seminolemuscle/V0.25/BOM/OpenBarbell_V0p25_BOM.xls

Bill of Materials (BOM) for OpenBarbell V0.25
Ref Des | Location | Description | Qty | Manufacturer | Mfg Part # | Type | Packaging | Datasheet | Link to Product
LED2 | Top | LED RED DIFFUSED 0805 SMD | 1 | OSRAM Opto Semiconductors Inc. (http://digikey.com/Suppliers/us/Osram.page?lang=en) | LH R974-LP-1 | SMD | 0805 (2012 Metric) | http://www.osram-os.com/Graphics/XPic8/00078869_0.pdf | http://www.digikey.com/scripts/DkSearch/dksus.dll?Detail&itemSeq=186757357&uq=635871091745723126
D1 | Top | DIODE SCHOTTKY 20V 1A SOD123 | 1 | Micro Commercial Co (http://digikey.com/Suppliers/us/Micro-Commercial-Components.page?lang=en) | MBRX120-TP | SMD | SOD-123 | http://www.mccsemi.com/up_pdf/MBRX120-MBRX160(SOD123).pdf | http://www.digikey.com/scripts/DkSearch/dksus.dll?Detail&itemSeq=186757358&uq=635871091745733126
C2 | Top | CAP TANT 10UF 6.3V 20% 0805 | 3 | AVX Corporation (http://digikey.com/Suppliers/us/AVX.page?lang=en) | F920J106MPA | SMD | 0805 (2012 Metric) | http://datasheets.avx.com/f92.pdf | http://www.digikey.com/scripts/DkSearch/dksus.dll?Detail&itemSeq=186757354&uq=635871091745733126
C7 | Top | CAP TANT 10UF 6.3V 20% 0805 | 3 | AVX Corporation (http://digikey.com/Suppliers/us/AVX.page?lang=en) | F920J106MPA | SMD | 0805 (2012 Metric) | http://datasheets.avx.com/f92.pdf | http://www.digikey.com/scripts/DkSearch/dksus.dll?Detail&itemSeq=186757354&uq=635871091745733126
C9 | Top | CAP TANT 10UF 6.3V 20% 0805 | 3 | AVX Corporation (http://digikey.com/Suppliers/us/AVX.page?lang=en) | F920J106MPA | SMD | 0805 (2012 Metric) | http://datasheets.avx.com/f92.pdf | http://www.digikey.com/scripts/DkSearch/dksus.dll?Detail&itemSeq=186757354&uq=635871091745733126
LED1 | Top | LED GREEN CLEAR 0805 SMD | 1 | Lite-On Inc. (http://digikey.com/Suppliers/us/Lite-On.page?lang=en) | LTST-C171GKT | SMD | 0805 (2012 Metric) | http://media.digikey.com/pdf/Data%20Sheets/Lite-On%20PDFs/LTST-C171GKT.pdf | http://www.digikey.com/scripts/DkSearch/dksus.dll?Detail&itemSeq=186757350&uq=635871091745743126
C10 | Top | CAP TANT POLY 68UF 6.3V 1411 | 1 | Kemet (http://digikey.com/Suppliers/us/Kemet.page?lang=en) | T520B686M006ATE025 | SMD | 1411 (3528 Metric) | http://www.kemet.com/Lists/ProductCatalog/Attachments/421/KEM_T2015_T520.pdf | http://www.digikey.com/product-detail/en/T520B686M006ATE025/399-5231-1-ND/1830043
C3 | Top | CAP CER 10000PF 50V X7R 0805 | 1 | Murata Electronics North America (http://digikey.com/Suppliers/us/Murata-Electronics.page?lang=en) | GRM216R71H103KA01D | SMD | 0805 (2012 Metric) | http://search.murata.co.jp/Ceramy/image/img/A01X/G101/ENG/GRM216R71H103KA01-01.pdf | http://www.digikey.com/scripts/DkSearch/dksus.dll?Detail&itemSeq=186757349&uq=635871091745753126
C4 | Top | CAP CER 1UF 16V X7R 0805 | 1 | Kemet (http://digikey.com/Suppliers/us/Kemet.page?lang=en) | C0805C105K4RACTU | SMD | 0805 (2012 Metric) | http://www.kemet.com/docfinder?Partnumber=C0805C105K4RACTU | http://www.digikey.com/scripts/DkSearch/dksus.dll?Detail&itemSeq=186757352&uq=635871091745753126
JST | Bottom | CONN HEADER PH SIDE 2POS 2MM SMD | 1 | JST Sales America Inc. (http://digikey.com/Suppliers/us/JST.page?lang=en) | S2B-PH-SM4-TB(LF)(SN) | SMD | 0805 (2012 Metric) | http://www.jst-mfg.com/product/pdf/eng/ePH.pdf | http://www.digikey.com/scripts/DkSearch/dksus.dll?Detail&itemSeq=186757348&uq=635871091745753126
R5 | Top | RES SMD 4.7K OHM 1% 1/8W 0805 | 1 | Yageo (http://digikey.com/Suppliers/us/Yageo.page?lang=en) | RC0805FR-074K7L | SMD | 0805 (2012 Metric) | http://www.yageo.com/NewPortal/yageodocoutput?fileName=/pdf/R-Chip/PYu-RC_Group_51_RoHS_L_3.pdf | http://www.digikey.com/scripts/DkSearch/dksus.dll?Detail&itemSeq=186757351&uq=635871091745763126
R6 | Top | RES SMD 1K OHM 5% 1/8W 0805 | 1 | Yageo (http://digikey.com/Suppliers/us/Yageo.page?lang=en) | RC0805JR-071KL | SMD | 0805 (2012 Metric) | http://www.yageo.com/NewPortal/yageodocoutput?fileName=/pdf/R-Chip/PYu-RC_Group_51_RoHS_L_3.pdf | http://www.digikey.com/scripts/DkSearch/dksus.dll?Detail&itemSeq=186757347&uq=635871091745763126
R7 | Top | RES SMD 590 OHM 1% 1/8W 0805 | 1 | Yageo (http://digikey.com/Suppliers/us/Yageo.page?lang=en) | RC0805FR-07590RL | SMD | 0805 (2012 Metric) | http://www.yageo.com/NewPortal/yageodocoutput?fileName=/pdf/R-Chip/PYu-RC_Group_51_RoHS_L_3.pdf | http://www.digikey.com/scripts/DkSearch/dksus.dll?Detail&itemSeq=186757345&uq=635871091745773126
R8 | Top | RES SMD 100 OHM 1% 1/8W 0805 | 2 | Yageo (http://digikey.com/Suppliers/us/Yageo.page?lang=en) | RC0805FR-07100RL | SMD | 0805 (2012 Metric) | http://www.yageo.com/NewPortal/yageodocoutput?fileName=/pdf/R-Chip/PYu-RC_Group_51_RoHS_L_3.pdf | http://www.digikey.com/scripts/DkSearch/dksus.dll?Detail&itemSeq=186757344&uq=635871091745773126
R3 | Top | RES SMD 100 OHM 1% 1/8W 0805 | 2 | Yageo (http://digikey.com/Suppliers/us/Yageo.page?lang=en) | RC0805FR-07100RL | SMD | 0805 (2012 Metric) | http://www.yageo.com/NewPortal/yageodocoutput?fileName=/pdf/R-Chip/PYu-RC_Group_51_RoHS_L_3.pdf | http://www.digikey.com/scripts/DkSearch/dksus.dll?Detail&itemSeq=186757344&uq=635871091745773126
U3 | Top | IC CONTROLLR LI-ION 4.2V SOT23-5 | 1 | Microchip Technology (http://digikey.com/Suppliers/us/Microchip-Technology.page?lang=en) | MCP73831T-2DCI/OT | SMD | SC-74A, SOT-753 | http://www.microchip.com/mymicrochip/filehandler.aspx?ddocname=en025112 | http://www.digikey.com/scripts/DkSearch/dksus.dll?Detail&itemSeq=186757343&uq=635871091745773126
U2 | Top | IC REG LDO 3.3V 0.15A SOT23-5 | 1 | Microchip Technology (http://digikey.com/Suppliers/us/Microchip-Technology.page?lang=en) | MIC5205-3.3YM5-TR | SMD | SOT-23-5 | http://www.microchip.com/mymicrochip/filehandler.aspx?ddocname=en579613 | http://www.digikey.com/product-search/en?vendor=0&keywords=576-1259-1-ND
C6 | Top | CAP CER 0.1UF 50V X7R 0805 | 1 | AVX Corporation (http://digikey.com/Suppliers/us/AVX.page?lang=en) | 08055C104KAT2A 08055C104KAT2A | SMD | 0805 (2012 Metric) | http://datasheets.avx.com/X7RDielectric.pdf | http://www.digikey.com/scripts/DkSearch/dksus.dll?Detail&itemSeq=186757342&uq=635871091745783126
U5 | Top | RFDUINO BLE 4.0 SMT MODULE | 1 | RF Digital Corporation | RFD22301 | SMD | 19-SMD Module | http://www.rfdigital.com/wp-content/uploads/2014/03/RFD22301.Data_.Sheet_.11.24.13_11.38PM.pdf | http://www.digikey.com/scripts/DkSearch/dksus.dll?Detail&itemSeq=186757341&uq=635871091745783126
L1 | Top | FIXED IND 47UH 720MA 370 MOHM | 1 | Sumida America Components Inc. (http://digikey.com/Suppliers/us/Sumida.page?lang=en) | CR54NP-470LC | SMD | Nonstandard | http://media.digikey.com/pdf/Data%20Sheets/Sumida%20PDFs/CR54_Series.pdf | http://www.digikey.com/scripts/DkSearch/dksus.dll?Detail&itemSeq=186757338&uq=635871091745793126
U4 | Top | IC REG BOOST 5V 0.13A 5TSOP | 1 | ON Semiconductor (http://digikey.com/Suppliers/us/ON-Semiconductor.page?lang=en) | NCP1402SN50T1G | SMD | SOT-23-5 | http://www.onsemi.com/pub_link/Collateral/NCP1402-D.PDF | http://www.digikey.com/scripts/DkSearch/dksus.dll?Detail&itemSeq=186757336&uq=635871091745793126
C8 | Top | CAP CER 4.7UF 6.3V X5R 0805 | 2 | Kemet (http://digikey.com/Suppliers/us/Kemet.page?lang=en) | C0805C475K9PACTU | SMD | 0805 (2012 Metric) | http://www.kemet.com/docfinder?Partnumber=C0805C475K9PACTU | http://www.digikey.com/product-detail/en/C0805C475K9PACTU/399-3134-1-ND/551639
C1 | Top | CAP CER 4.7UF 6.3V X5R 0805 | 2 | Kemet (http://digikey.com/Suppliers/us/Kemet.page?lang=en) | C0805C475K9PACTU | SMD | 0805 (2012 Metric) | http://www.kemet.com/docfinder?Partnumber=C0805C475K9PACTU | http://www.digikey.com/product-detail/en/C0805C475K9PACTU/399-3134-1-ND/551639
C3 | Top | CAP CER 1000PF 50V NP0 0805 | 1 | AVX Corporation (http://digikey.com/Suppliers/us/AVX.page?lang=en) | 08055A102JAT2A | SMD | 0805 (2012 Metric) | http://datasheets.avx.com/C0GNP0-Dielectric.pdf | http://www.digikey.com/product-detail/en/08055A102JAT2A/478-1328-1-ND/564360
U1 | Top | Battery Management MAX17043G+U | 1 | Maxim Integrated (http://www.mouser.com/maxim-integrated/) | MAX17043G+U | SMD | TDFN-8 | http://datasheets.maximintegrated.com/en/ds/MAX17043-MAX17044.pdf | http://www.digikey.com/product-search/en?keywords=MAX17043G%2BU
R4 | Top | RES SMD 2K OHM 1% 1/8W 0805 | 1 | Yageo (http://digikey.com/Suppliers/us/Yageo.page?lang=en) | RC0805FR-072KL | SMD | 0805 (2012 Metric) | http://www.yageo.com/NewPortal/yageodocoutput?fileName=/pdf/R-Chip/PYu-RC_Group_51_RoHS_L_3.pdf | http://www.digikey.com/product-detail/en/RC0805FR-072KL/311-2.00KCRCT-ND/730611
SW3 | Top | SWITCH TACTILE SPST-NO 0.05A 12V | 2 | Grayhill Inc. (http://digikey.com/Suppliers/us/Grayhill.page?lang=en) | 95C06F3GWT | SMD | Gull Wing (6.2 mm x 6.2 mm) | http://www.grayhill.com/assets/1/7/Tact_95C06.pdf | http://www.digikey.com/product-detail/en/95C06F3GWT/95C06F3GWT-ND/2681049
SW2 | Top | SWITCH TACTILE SPST-NO 0.05A 12V | 2 | Grayhill Inc. (http://digikey.com/Suppliers/us/Grayhill.page?lang=en) | 95C06F3GWT | SMD | Gull Wing (6.2 mm x 6.2 mm) | http://www.grayhill.com/assets/1/7/Tact_95C06.pdf | http://www.digikey.com/product-detail/en/95C06F3GWT/95C06F3GWT-ND/2681049
SW1 | Top | C&K Components AYZ0102AGRLC SWITCH SLIDE SPDT 100MA 12V | 1 | C&K Components (http://digikey.com/Suppliers/us/Grayhill.page?lang=en) | AYZ0102AGRLC | SMD | n/a | http://www.ck-components.com/index.php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 | http://www.digikey.com/scripts/DkSearch/dksus.dll?Detail&itemSeq=187430306&uq=635881208933649085
USB | Top | MICRO USB, 2.0 TYPE B, RECEPTACLE, TH | 1 | Connector Receptacle USB - micro B 2.0 5 Position Surface Mount, Right Angle, Horizontal (http://www.newark.com/global-connector-technology) | 10118192-0001LF | SMD | n/a | http://media.digikey.com/pdf/Data%20Sheets/FCI%20PDFs/10118192-0001LF_Webpage.PDF | http://www.digikey.com/scripts/DkSearch/dksus.dll?Detail&itemSeq=187430057&uq=635881215589011586
ENC1 | Top | EMITTER IR 880NM 50MA RADIAL | 1 | Honeywell Sensing and Productivity Solutions | SEP8706-002 | Thru Hole |  | http://media.digikey.com/pdf/Data%20Sheets/Honeywell%20Sensing%20&%20Control%20PDFs/SEP8706.pdf | http://www.digikey.com/product-search/en?keywords=480-1966-ND
ENC2 | Top | SENSOR LOGIC OUT OPTIC SIDE VIEW | 1 | Honeywell Sensing and Productivity Solutions | HLC2705-001 | Thru Hole |  | http://media.digikey.com/pdf/Data%20Sheets/Honeywell%20Sensing%20&%20Control%20PDFs/HLC2705.pdf | http://www.digikey.com/product-search/en?keywords=HLC2705
OLED | Top | 0.96 Inch 4Pin BLUE IIC I2C OLED Display Module | 1 |  |  | Thru Hole |  | http://www.banggood.com/0_96-Inch-4Pin-White-IIC-I2C-OLED-Display-Module-12864-LED-For-Arduino-p-958196.html | http://www.banggood.com/5Pcs-0_96-Inch-4Pin-White-IIC-I2C-OLED-Display-Module-For-Arduino-p-971295.html
 |  |  |  |  |  |  |  | Digikey Cart: | http://www.digikey.com/short/3cjzr4
 |  |  |  |  |  |  |  | Note: Items in this color are currently not stocked, or unable to be purchased on Digikey. Use above links to source, or find other sources online.
