seminolemuscle/V0.25/CAD/PCB_Final.SLDASM

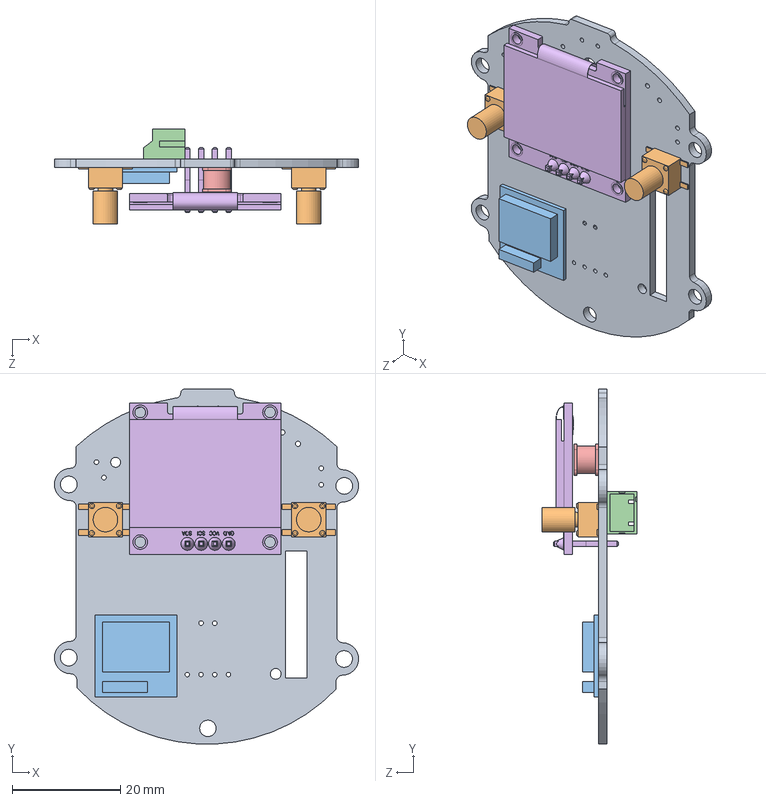
[picture p1: CAD file, 2016-01-14]
CAD/PCB_Final.SLDASM
56.3 x 65.7 x 17.5 mm
JDL_PCB_From_Eagle
JDL_95C06F3GWT_TactSwitch x 2
JDL_RFDuino
JDL_JST_Female
JDL_Inductor
OLED_NoOffset
