seminolemuscle/V0.25/CAD/Assembly.SLDASM

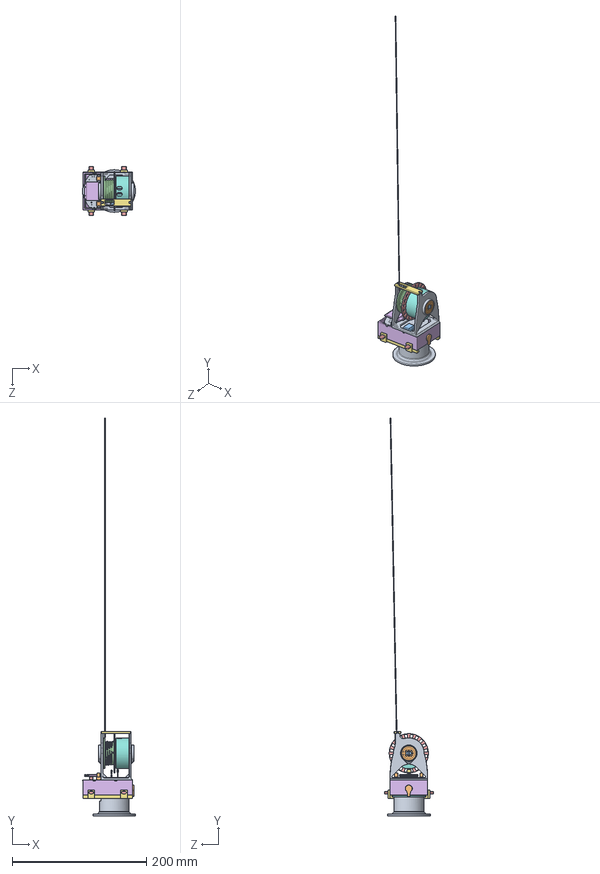
[picture p2: CAD file, 2016-01-14]
CAD/Assembly.SLDASM
79.0 x 593.1 x 72.6 mm
Housing
608 bearing x 2
Axel
Spindle Encoder
Spindle Housing
Battery compartment
Compartment Bottom
Pillar
Pillar Base
Pillar Lock
Pillar Lock Flange
Piller Balance
Dowel x 4
Battery Case
String Guard
Spring Mount Thin
JDL_PCB_From_Eagle
JDL_95C06F3GWT_TactSwitch x 2
JDL_RFDuino
JDL_JST_Female
JDL_Inductor
OLED_NoOffset
Emitter_Detector
