seminolemuscle/V0.25/CAD/String Hook.SLDPRT

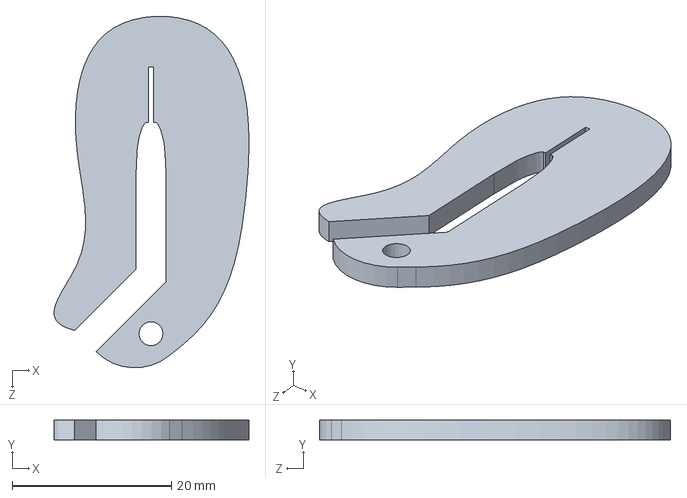
[picture p3: CAD file, 2016-05-04]
CAD/String Hook.SLDPRT
24.5 x 2.50 x 44.1 mm
