seminolemuscle/V0.25/STL/Spring Mount Wide.STL

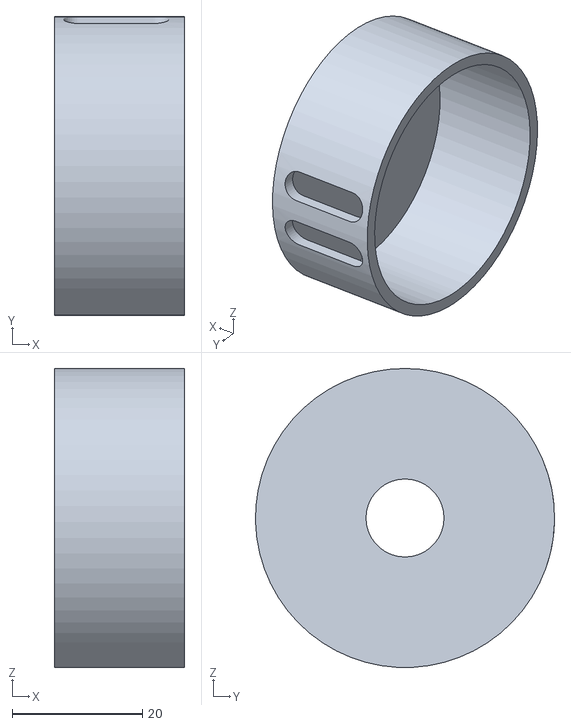
[picture p4: CAD file, 2016-01-14]
STL/Spring Mount Wide.STL
20.0 x 46.0 x 46.0
