seminolemuscle/V0.25/CAD/JDL_RFDuino.SLDPRT

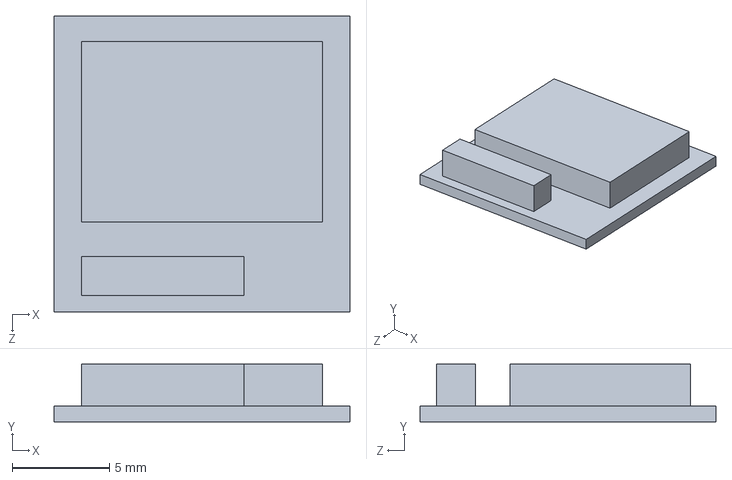
[picture p5: CAD file, 2016-01-14]
CAD/JDL_RFDuino.SLDPRT
15.2 x 2.97 x 15.2 mm
