seminolemuscle/V0.25/STL/Screen Mount.STL

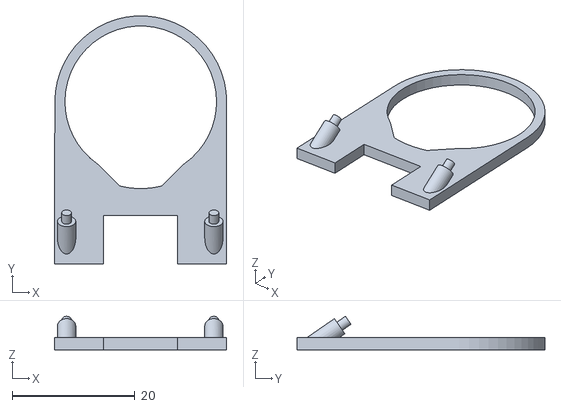
[picture p6: CAD file, 2016-01-14]
STL/Screen Mount.STL
28.1 x 40.4 x 5.47
