seminolemuscle/V0.25/CAD/Piller Balance.sldprt

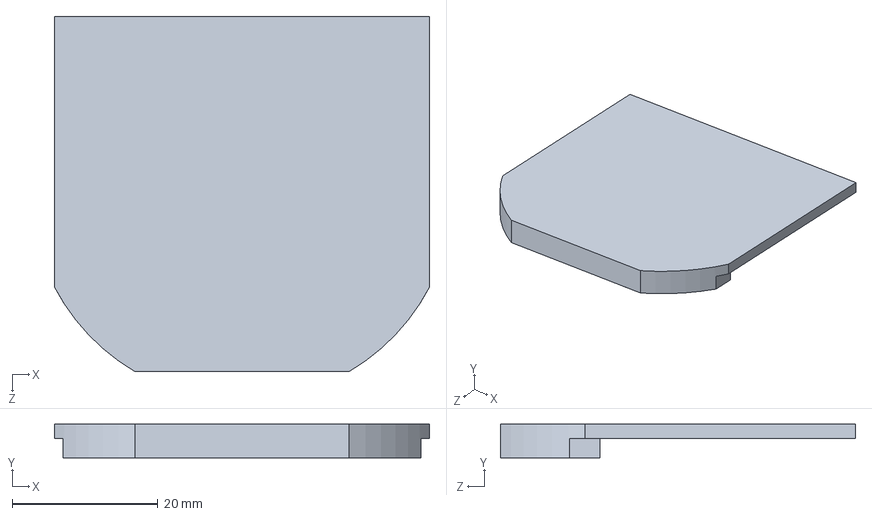
[picture p7: CAD file, 2016-01-14]
CAD/Piller Balance.sldprt
51.4 x 4.63 x 48.7 mm
