seminolemuscle/V0.25/STL/Dowelx4.STL

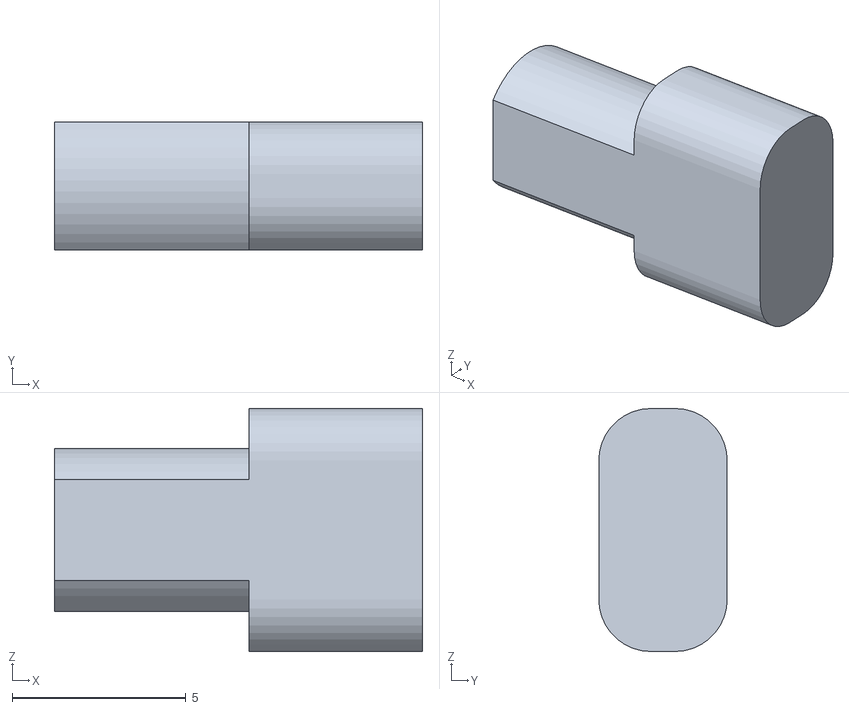
[picture p8: CAD file, 2016-01-14]
STL/Dowelx4.STL
10.6 x 3.70 x 7.00
