seminolemuscle/V0.25/CAD/Spring Mount Thin.SLDPRT

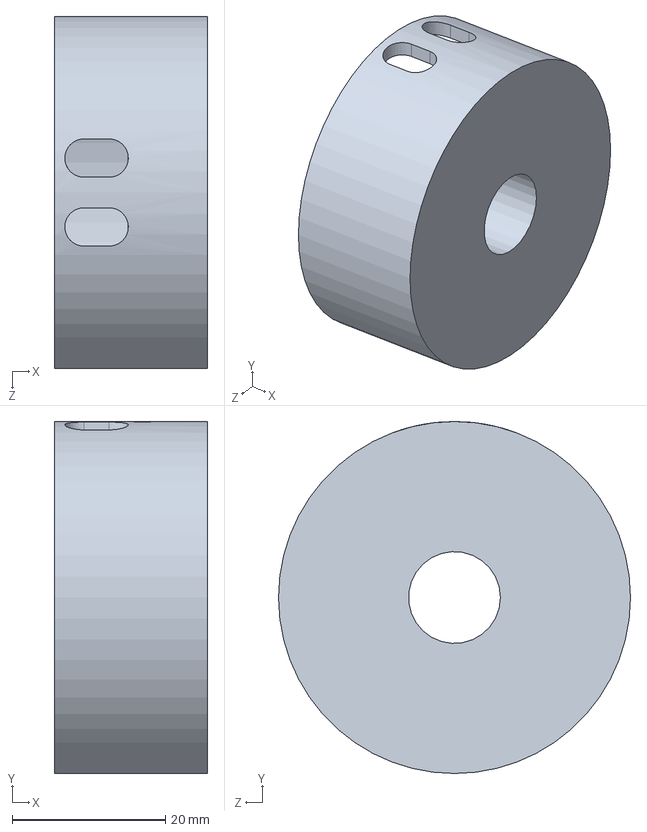
[picture p9: CAD file, 2016-01-14]
CAD/Spring Mount Thin.SLDPRT
20.0 x 46.0 x 46.0 mm
