seminolemuscle/V0.25/STL/String Guard.STL

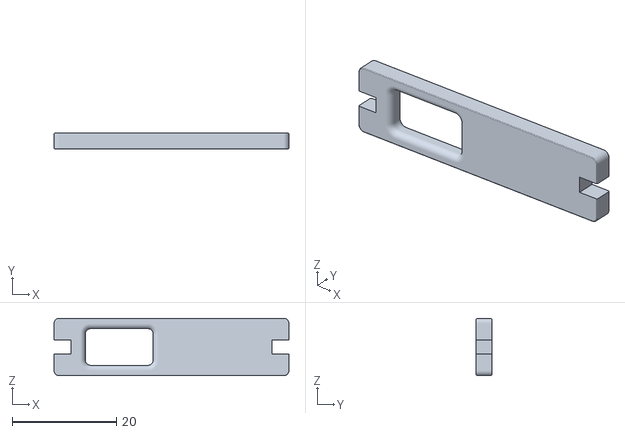
[picture p10: CAD file, 2016-01-14]
STL/String Guard.STL
45.0 x 3.00 x 11.0
