seminolemuscle/V0.25/CAD/608 bearing.SLDPRT

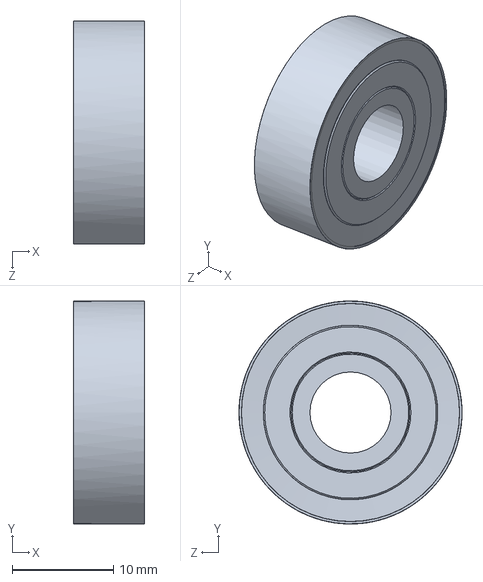
[picture p11: CAD file, 2016-01-14]
CAD/608 bearing.SLDPRT
7.00 x 22.0 x 22.0 mm
