seminolemuscle/V0.25/CAD/Emitter_Detector.SLDPRT

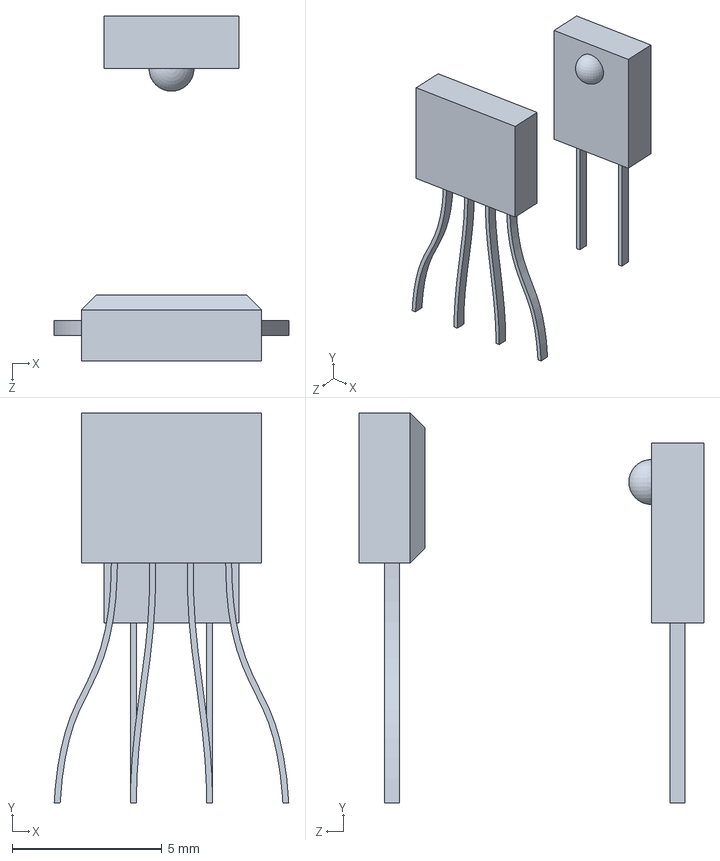
[picture p12: CAD file, 2016-01-14]
CAD/Emitter_Detector.SLDPRT
7.82 x 13.0 x 11.5 mm
