seminolemuscle/V0.25/CAD/Spindle Housing.SLDPRT

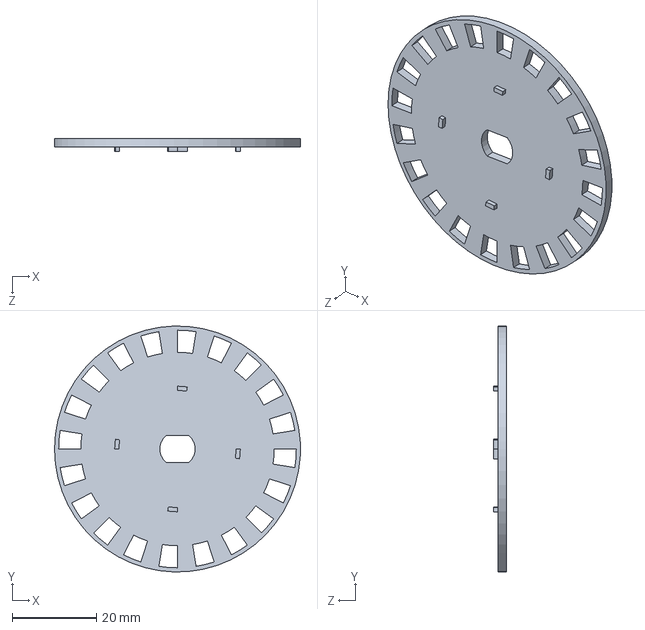
[picture p13: CAD file, 2016-01-14]
CAD/Spindle Housing.SLDPRT
58.5 x 58.5 x 3.00 mm
