seminolemuscle/V0.25/CAD/Pillar Base.SLDPRT

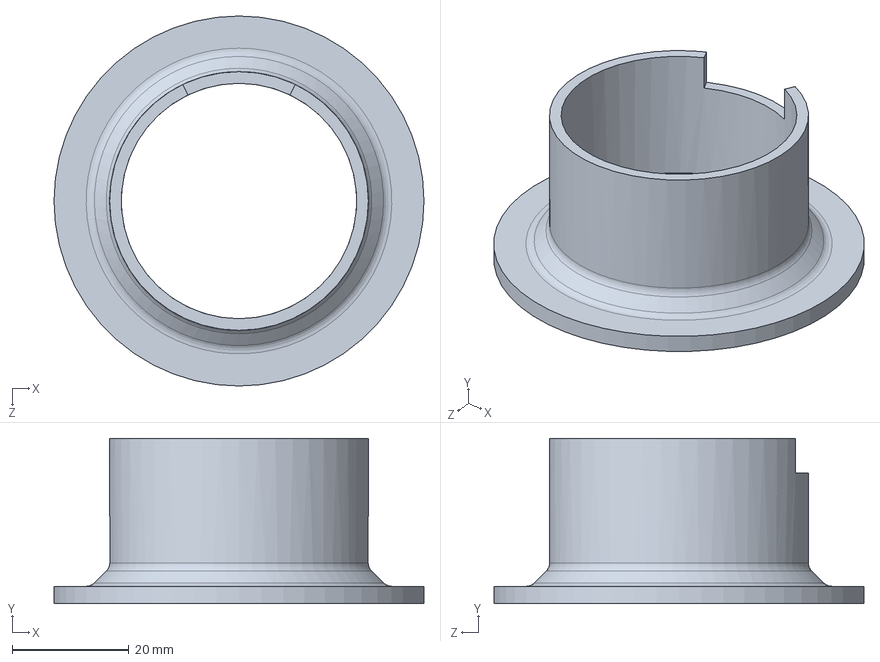
[picture p14: CAD file, 2016-01-14]
CAD/Pillar Base.SLDPRT
63.5 x 28.4 x 63.5 mm
