seminolemuscle/V0.25/CAD/JDL_95C06F3GWT_TactSwitch.SLDPRT

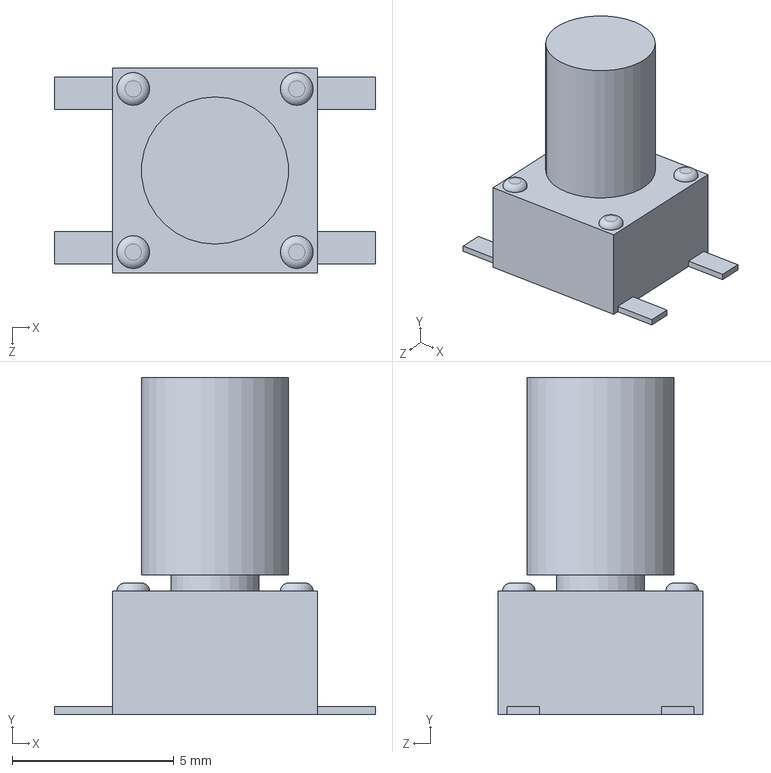
[picture p15: CAD file, 2016-01-14]
CAD/JDL_95C06F3GWT_TactSwitch.SLDPRT
9.93 x 10.4 x 6.35 mm
