seminolemuscle/V0.25/CAD/Pillar Lock Flange.SLDPRT

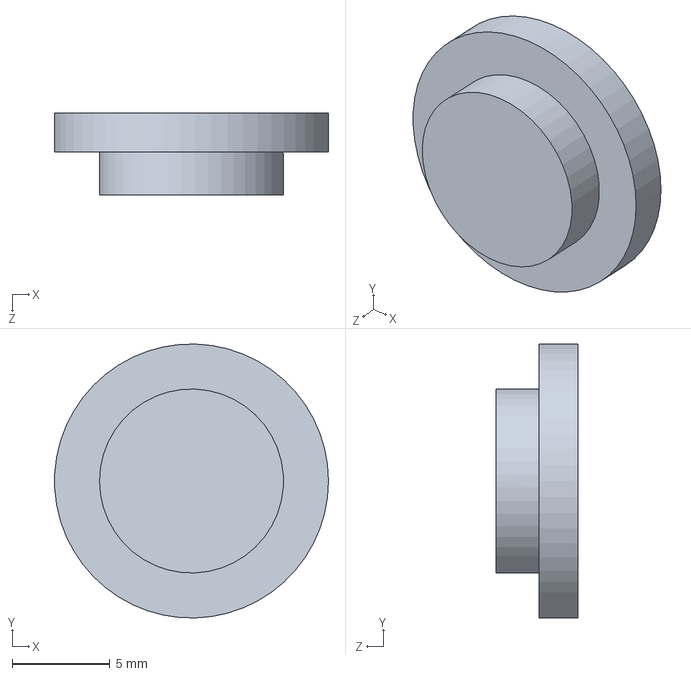
[picture p16: CAD file, 2016-01-14]
CAD/Pillar Lock Flange.SLDPRT
14.0 x 14.0 x 4.20 mm
