seminolemuscle/V0.25/CAD/Housing.SLDPRT

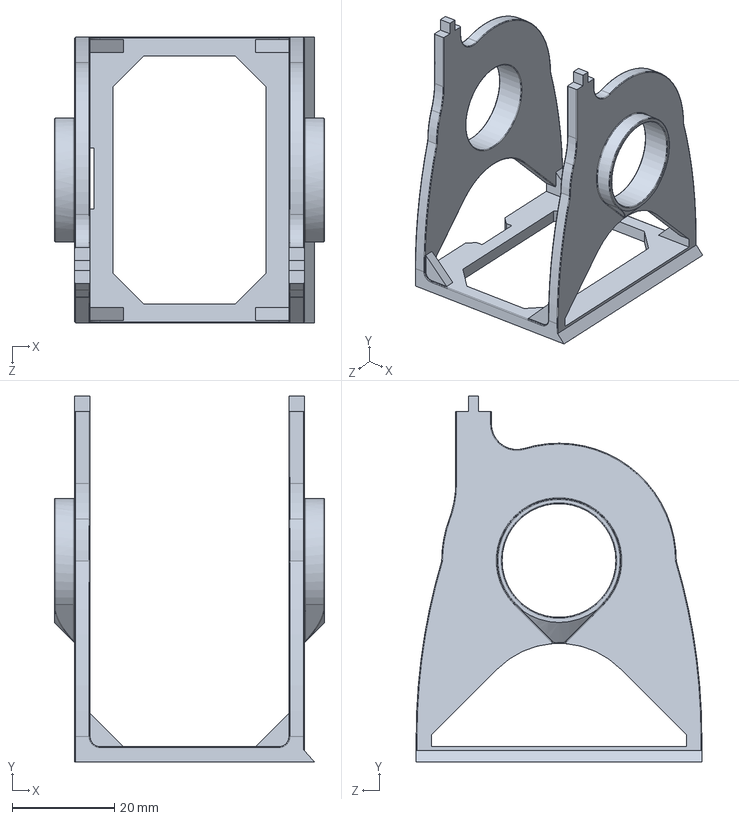
[picture p17: CAD file, 2016-01-14]
CAD/Housing.SLDPRT
53.0 x 71.8 x 56.0 mm
