seminolemuscle/V0.25/CAD/Axel.SLDPRT

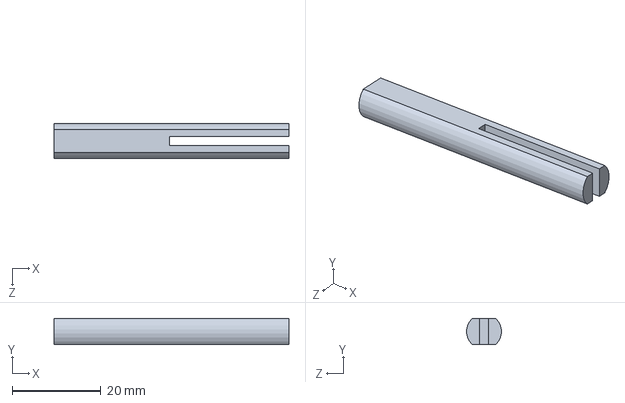
[picture p18: CAD file, 2016-01-14]
CAD/Axel.SLDPRT
53.0 x 5.90 x 7.84 mm
