seminolemuscle/V0.25/CAD/JDL_JST_Female.SLDPRT

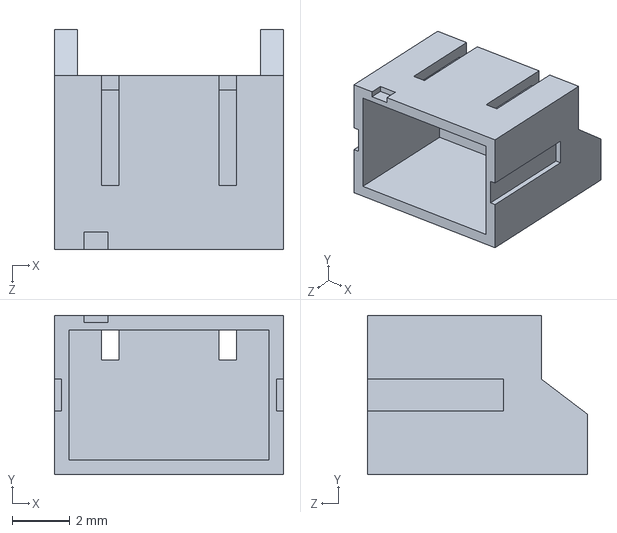
[picture p19: CAD file, 2016-01-14]
CAD/JDL_JST_Female.SLDPRT
7.90 x 5.50 x 7.60 mm
