seminolemuscle/V0.25/CAD/JDL_Inductor.SLDPRT

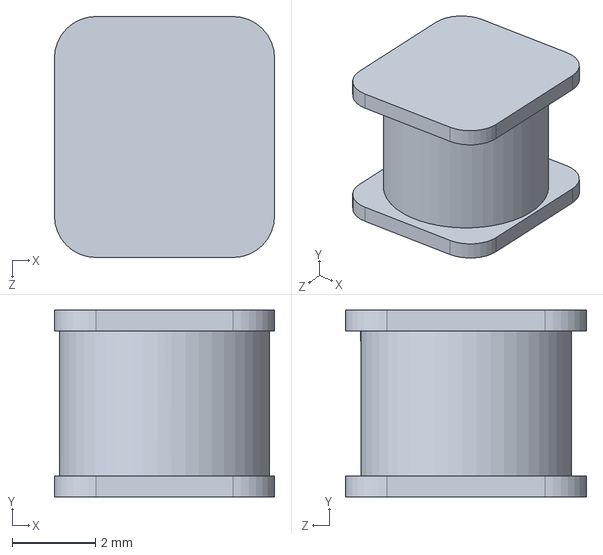
[picture p20: CAD file, 2016-01-14]
CAD/JDL_Inductor.SLDPRT
5.30 x 4.50 x 5.80 mm
