seminolemuscle/V0.25/CAD/Pillar Lock.sldprt

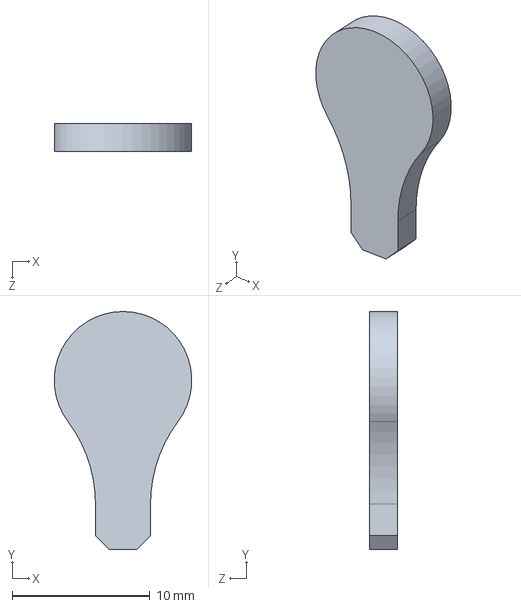
[picture p21: CAD file, 2016-01-14]
CAD/Pillar Lock.sldprt
9.99 x 17.3 x 2.00 mm
