seminolemuscle/V0.25/CAD/Battery compartment.SLDPRT

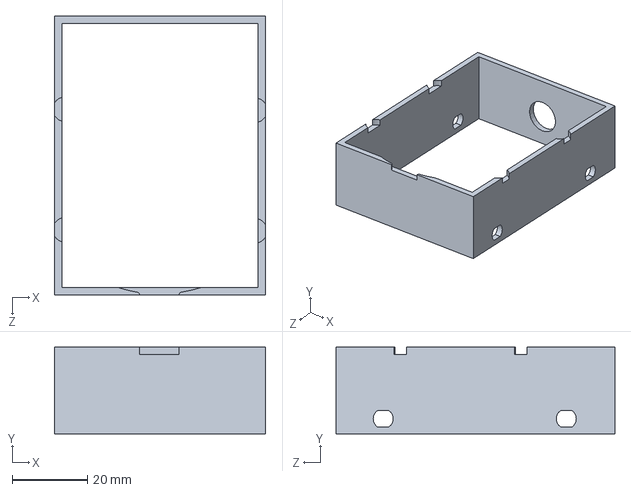
[picture p22: CAD file, 2016-01-14]
CAD/Battery compartment.SLDPRT
56.0 x 23.0 x 74.0 mm
