seminolemuscle/V0.25/CAD/JDL_PCB_From_Eagle.SLDPRT

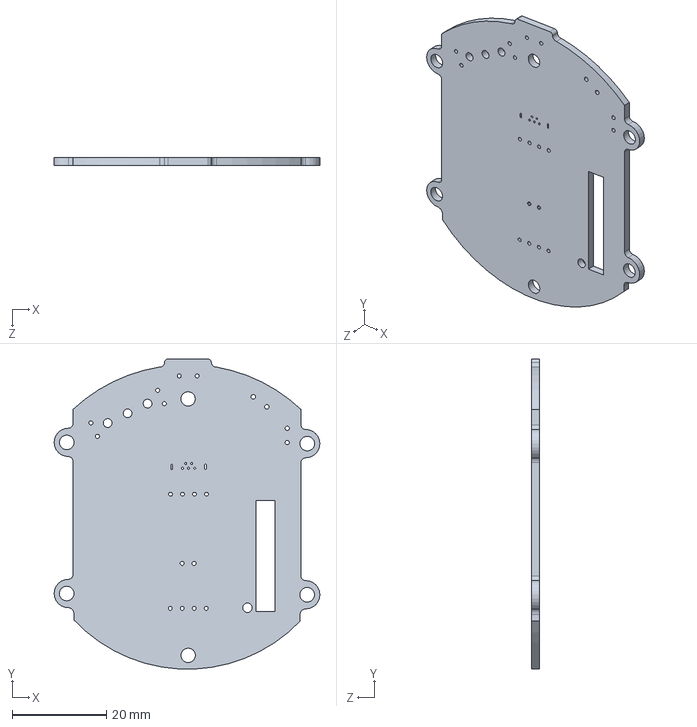
[picture p23: CAD file, 2016-01-14]
CAD/JDL_PCB_From_Eagle.SLDPRT
56.3 x 65.7 x 1.61 mm
