seminolemuscle/V0.25/CAD/Pillar.SLDPRT

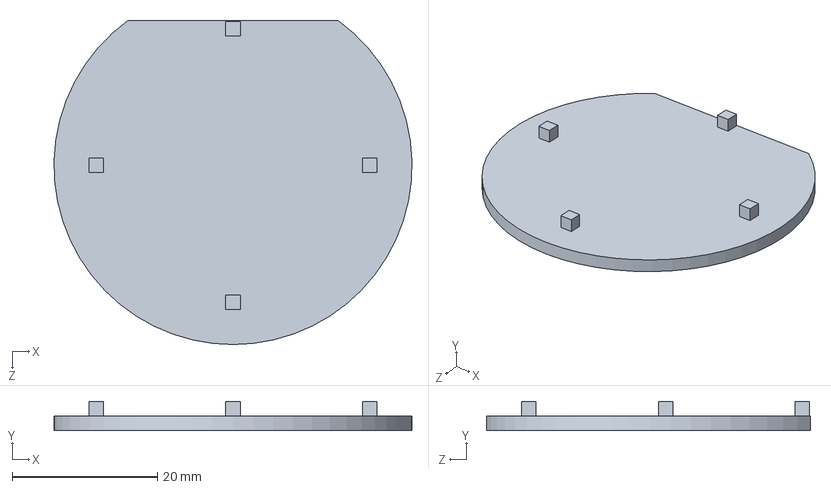
[picture p24: CAD file, 2016-01-14]
CAD/Pillar.SLDPRT
49.4 x 4.00 x 44.7 mm
