seminolemuscle/V0.25/CAD/Compartment Bottom.sldprt

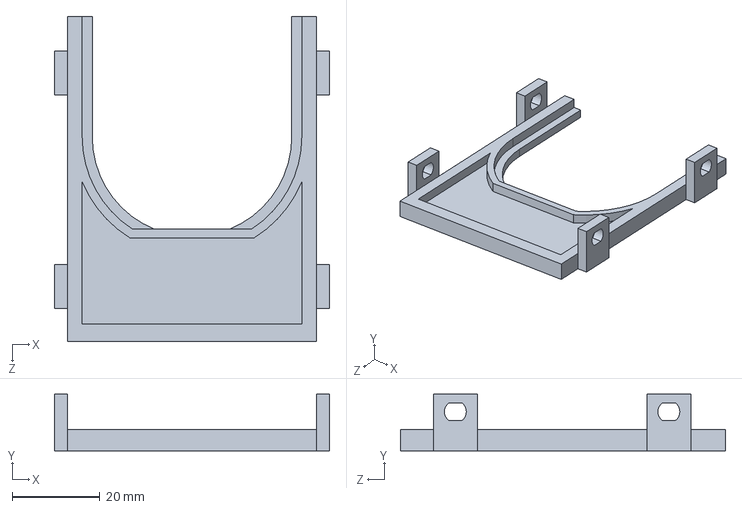
[picture p25: CAD file, 2016-01-14]
CAD/Compartment Bottom.sldprt
62.6 x 12.9 x 74.0 mm
