seminolemuscle/V0.25/CAD/Spindle Encoder.SLDPRT

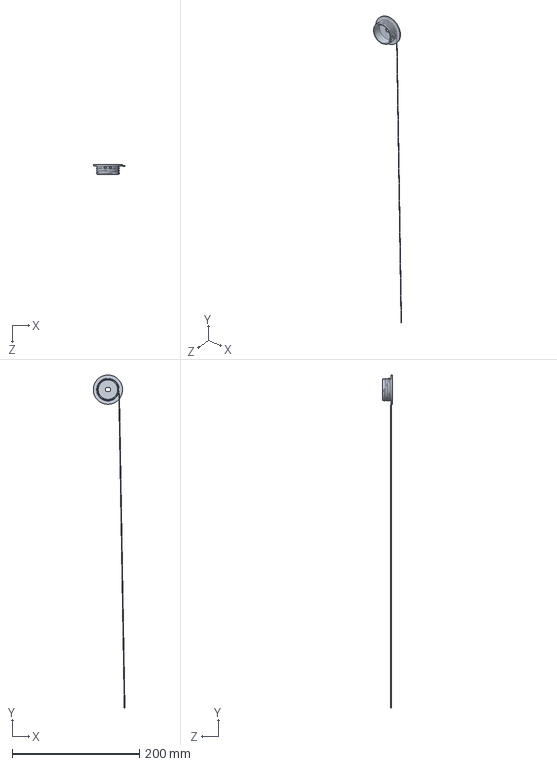
[picture p26: CAD file, 2016-01-14]
CAD/Spindle Encoder.SLDPRT
49.4 x 522.6 x 15.0 mm
