seminolemuscle/V0.25/CAD/OLED_NoOffset.SLDPRT

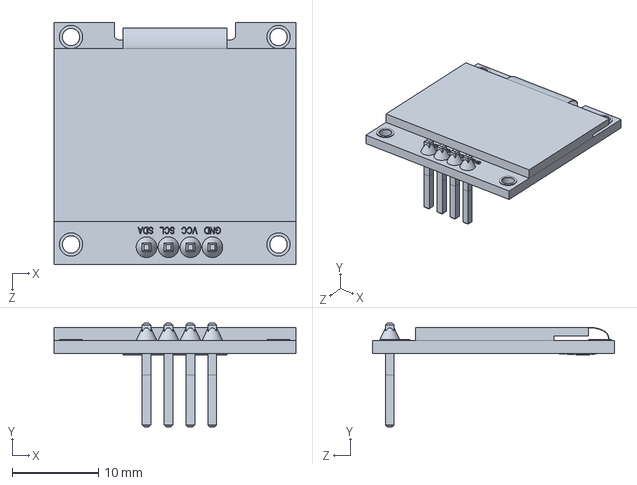
[picture p27: CAD file, 2016-01-14]
CAD/OLED_NoOffset.SLDPRT
28.0 x 12.0 x 28.0 mm
