seminolemuscle/V0.25/CAD/Battery Case.SLDPRT

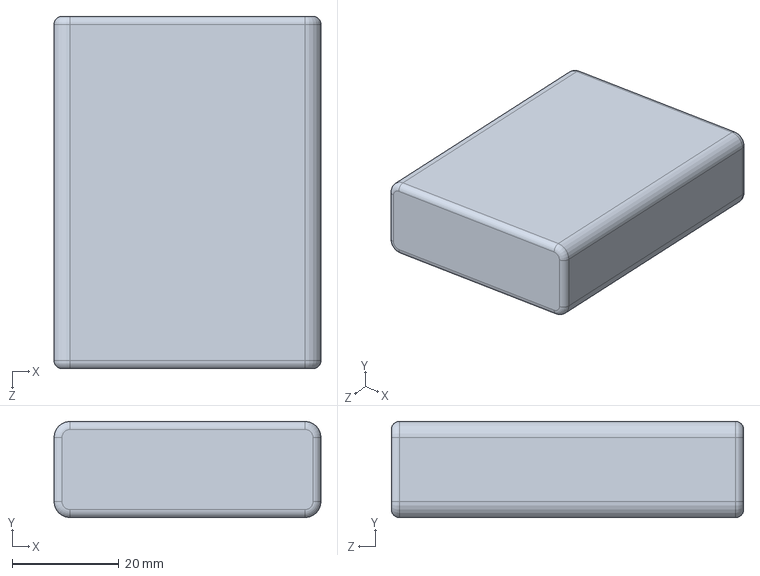
[picture p28: CAD file, 2016-01-14]
CAD/Battery Case.SLDPRT
50.0 x 18.0 x 66.0 mm
