seminolemuscle/V0.25/(list of files, cad)

Other CAD files:
CAD/Dowel.SLDPRT
STL/Axel.STL
STL/Battery compartment.STL
STL/Compartment Bottom.STL
STL/Housing.STL
STL/Pillar Base.STL
STL/Pillar Lock Flange.STL
STL/Pillar Lock.STL
STL/Pillar.STL
STL/Piller Balance.STL
STL/Spindle Encoder.STL
STL/Spindle Housing.STL
STL/Spring Mount Thin.STL
STL/String Hook.STL
