seminolemuscle/V0.25/Eagle/OpenBarbell3b2.brd

## EAGLE design Eagle/OpenBarbell3b2.brd (2016-01-14)

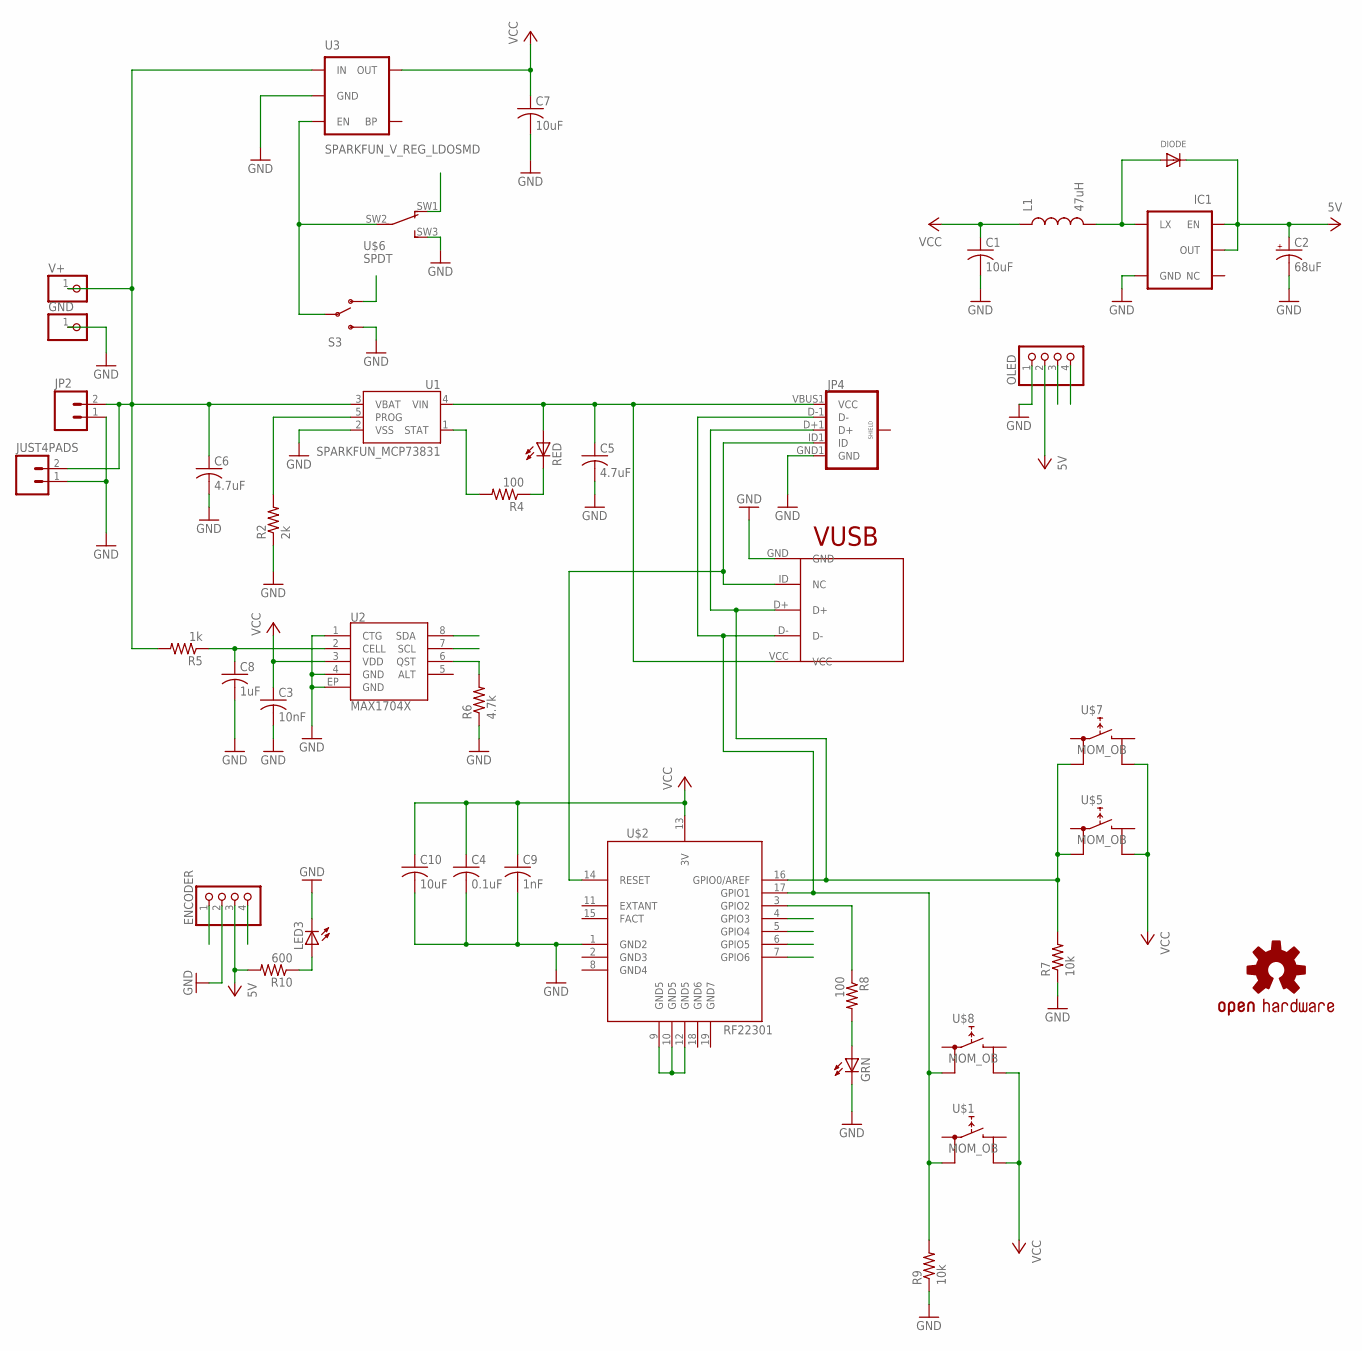
[picture p29: schematic OpenBarbell3b2.sch]

Parts:
C1, C7, C10: 10uF; C0805; MPN MC0805B102K101CT
C2: 68uF; SPARKFUN_EIA3528; MPN T520B686M006ATE025
C3: 10nF; C0805; MPN MC0805B103M500CT
C4: 0.1uF; C0805; MPN MC0805B104M160CT
C5, C6: 4.7uF; C0805; MPN MC0805B102K101CT
C8: 1uF; C0805; MPN C0805C105M4VACTU
C9: 1nF; C0805; MPN MC0805B102K101CT
DIODE: DIODESOD-123; SOD-123
ENCODER: PINHD-1X3CB; 1X03-CLEANBIG
GND: PINHD-1X1; 1X01
GRN: LEDCHIPLED_0805; CHIPLED_0805
IC1: SPARKFUN_V_REG_NCP1400SOT23-5; SPARKFUN_SOT23-5; MPN NCP1402SN33T1G
JP2: SPARKFUN_M02-JST-2MM-SMT; SPARKFUN_JST-2-SMD; MPN S2B-PH-SM4-TB(LF)(SN)
JP4: USB_MICROB_PLUGCONN-11752; USB-B-MICRO-SMD_V03
JUST4PADS: SPARKFUN_M02-JST-2MM-SMT; SPARKFUN_JST-2-SMD; MPN S2B-PH-SM4-TB(LF)(SN)
L1: 47uH; SPARKFUN_CR54; MPN SRF1280-470M
LED3: LED3MM; MPN MCL034SBLC
OLED: PINHD-1X3CB; 1X03-CLEANBIG
R2: 2k; R0805; MPN MCHP05W4F4701T5E
R4, R8: 100; R0805; MPN MCHP05W4F3300T5E
R5: 1k; R0805; MPN RR1220P-102-D
R6: 4.7k; R0805; MPN MCHP05W4F4701T5E
R7, R9: 10k; R0805; MPN MCHP05W4F1002T5E
R10: 600; R0805; MPN MMZ2012S601A
RED: LEDCHIPLED_0805; CHIPLED_0805
S3: SWITCH-SPDTSMD2; SWITCH-SPDT-SMD
U1: SPARKFUN_MCP73831; SPARKFUN_SOT23-5; MPN MCP73831T-2DCI/OT
U2: MAX1704X; TDFN-8
U3: SPARKFUN_V_REG_LDOSMD; SPARKFUN_SOT23-5; MPN MIC5205-3.3YM5 TR
U$1, U$5, U$7, U$8: MOM_OB; MOM_
U$2: RF22301; RFD22301
U$3: USB-MICRO-B-VERTICAL_SMD; USB-MICRO-B-VERTICAL-SMD
U$4: SPARKFUN_OSHW-LOGOL; SPARKFUN_OSHW-LOGO-L
U$6: SPDT
V+: PINHD-1X1; 1X01

Connections:
5V: C2.A (+), DIODE.C, ENCODER.3, IC1.1 (EN), IC1.2 (OUT), OLED.2, R10.2
12345: C6.1, JP2.2, JUST4PADS.2, R5.2, S3.1 (O), U1.3 (VBAT), U3.1 (IN), U$6.SW1, V+.1
DIR: ENCODER.4, U$2.4 (GPIO3)
GND: C1.2, C2.C (-), C3.2, C4.2, C5.2, C6.2, C7.2, C8.2, C9.2, C10.2, ENCODER.2, GND.1, GRN.C, IC1.4 (GND), JP2.1, JP4.GND1 (GND), JUST4PADS.1, LED3.K (C), OLED.1, R2.1, R6.1, R7.1, R9.1, S3.3 (S), U1.2 (VSS), U2.1 (CTG), U2.4 (GND), U2.EP (GND), U3.2 (GND), U$2.1 (GND2), U$3.GND, U$6.SW3
GND3: U$2.2 (GND3)
GND4: U$2.8 (GND4)
GND5: U$2.9 (GND5), U$2.10 (GND5), U$2.12 (GND5)
GND6: U$2.18 (GND6)
GND7: U$2.19 (GND7)
unnamed: R6.2, U2.6 (QST)
unnamed: DIODE.A, IC1.5 (LX), L1.P$2 (2)
unnamed: LED3.A, R10.1
unnamed: C8.1, R5.1, U2.2 (CELL)
unnamed: C5.1, JP4.VBUS1 (VCC), RED.A, U1.4 (VIN), U$3.VCC
unnamed: R4.1, RED.C
unnamed: R2.2, U1.5 (PROG)
unnamed: R4.2, U1.1 (STAT)
unnamed: GRN.A, R8.2
unnamed: R8.1, U$2.3 (GPIO2)
unnamed: S3.2, U3.3 (EN), U$6.SW2
unnamed: JP4.ID1 (ID), U$2.14 (RESET), U$3.ID (NC)
unnamed: JP4.D+1 (D+), R7.2, U$2.16 (GPIO0/AREF), U$3.D+, U$5.T2, U$7.T2
unnamed: JP4.D-1 (D-), R9.2, U$1.T2, U$2.17 (GPIO1), U$3.D-, U$8.T2
SCL: OLED.3, U2.7 (SCL), U$2.6 (GPIO5)
SDA: OLED.4, U2.8 (SDA), U$2.7 (GPIO6)
TACH: ENCODER.1, U$2.5 (GPIO4)
VCC: C1.1, C3.1, C4.1, C7.1, C9.1, C10.1, L1.P$1 (1), U2.3 (VDD), U3.5 (OUT), U$1.T4, U$2.13 (3V), U$5.T4, U$7.T4, U$8.T4

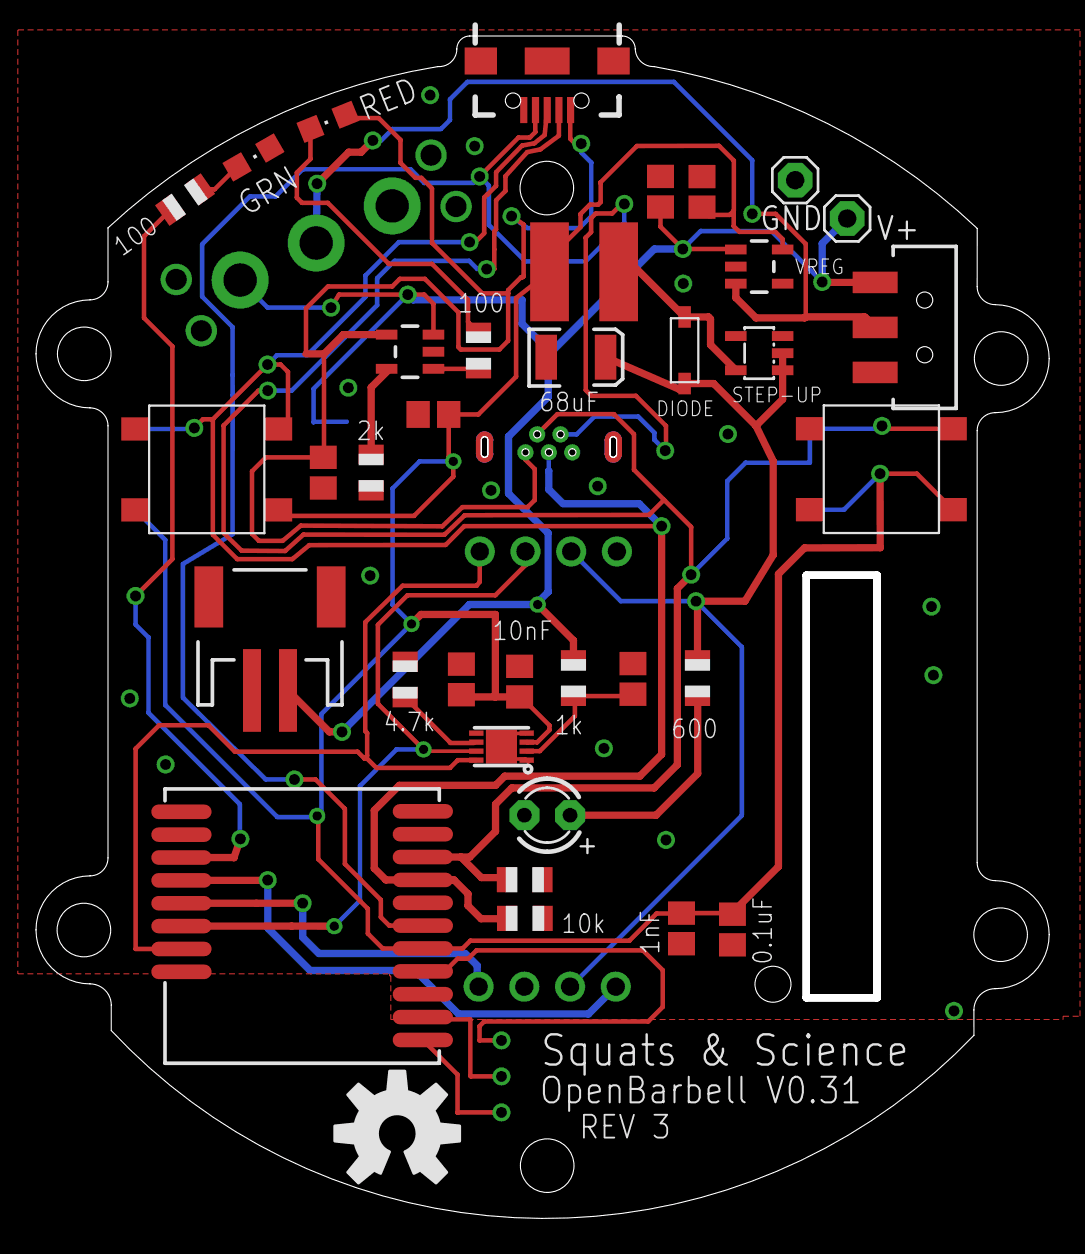
[picture p30: board OpenBarbell3b2.brd from above]

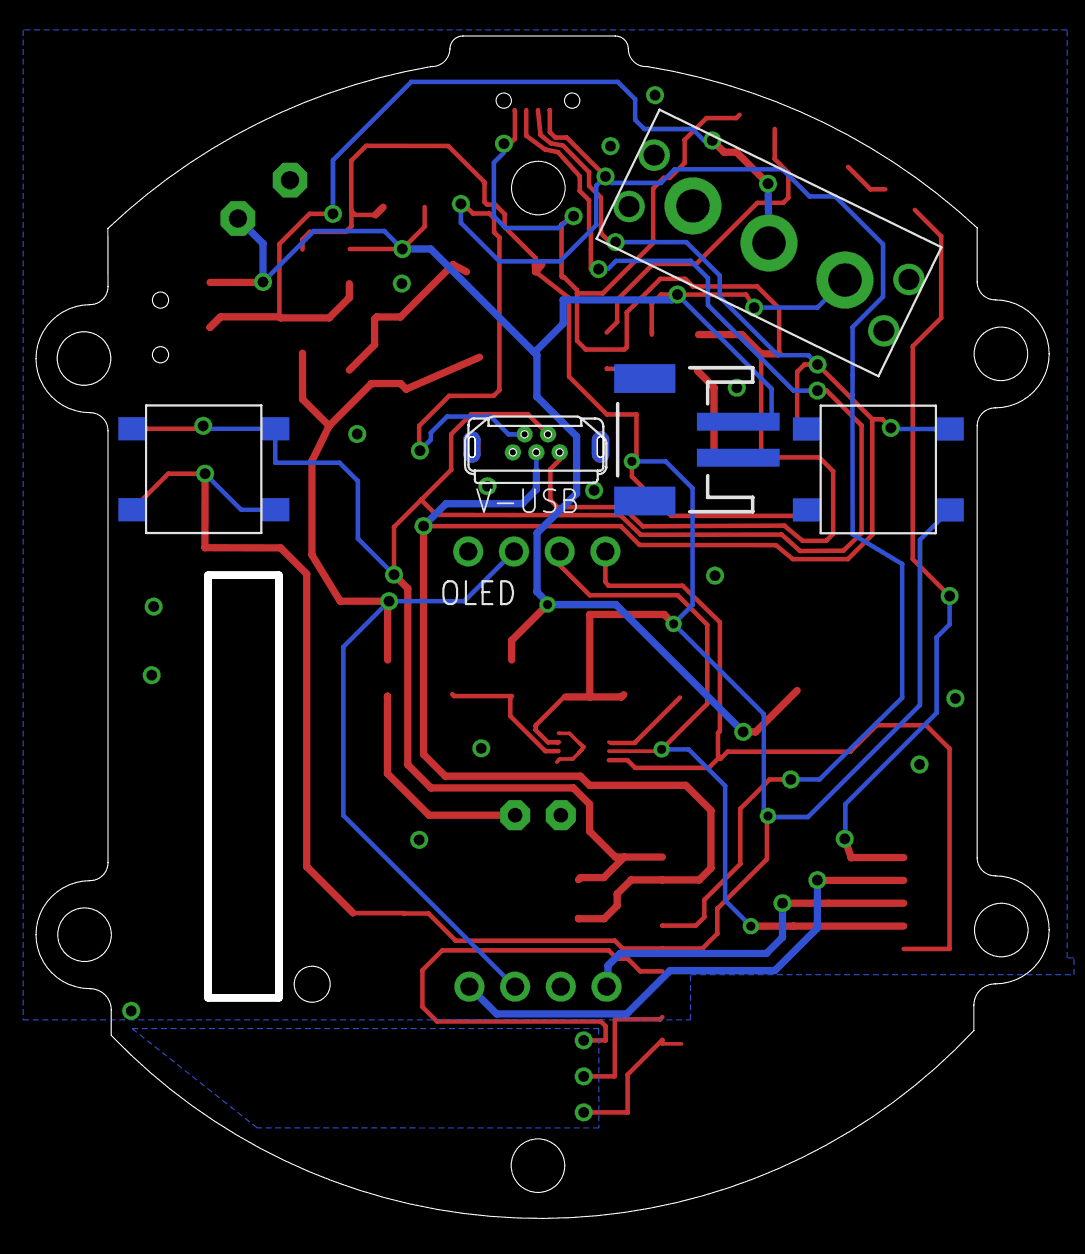
[picture p31: board OpenBarbell3b2.brd from below]

Board: 2 copper layers, 56.3 x 65.7 mm, 43 parts (6 on the bottom side), 23 nets.
