seminolemuscle/V0.25/(commit log)

2016-01-14 Committing BOM, CAD, STL's, Eagle CAD, Arduino code, and reference designators for OpenBarbell V0.25
    Full suite of design files for making your own OpenBarbell device.
    [608 bearing.SLDPRT, Assembly.SLDASM, Axel.SLDPRT, Axel.STL, Battery Case.SLDPRT, Battery compartment.SLDPRT, Battery compartment.STL, Compartment Bottom.STL]
2016-05-04 adding string hook
    [String Hook.SLDPRT]
