seminolemuscle/V0.25/(notices)

Notices in the files:
parts and their libraries:
GeekAmmo: Licensing:Creative Commons ShareAlike 4.0 International - https://creativecommons.org/licenses/by-sa/4.0
